praveenreddy0073/Disaster-Resilient-Offline-LoRa-SOS-Communication/LoRa_SOS_Professional_v2.pptx

OFFLINE

ESP32 LoRa Mesh

SOS Emergency
Communication System

Offline ESP32 LoRa Mesh SOS System · Full Firmware + Captive Portal + Rescue Dashboard

SOS

EMERGENCY BEACON

433 MHz · ESP32 · LoRa · FreeRTOS

Department of Electronics & Communication

2026

Captive Portal

Mesh Relay

Rescue Dashboard

~3 km

LoRa Range

< $15

Cost / Node

0 Internet

Required

1 / 11

## Slide 2

Table of Contents

What we will cover today

Offline ESP32 LoRa Mesh SOS System

Project Overview & Motivation

Why offline LoRa beats cellular in emergencies

Node 3 — Mesh Relay

Hop limit, dedup cache, jitter anti-collision

01

06

System Architecture

3-node mesh: Transmitter → Relay → Base Station

Software Stack

Arduino IDE, libraries, FreeRTOS architecture

02

07

Hardware & Wiring

ESP32 + LoRa SX1278 + I²C LCD pin mapping

03

Live Demo Flow

8-step walkthrough: Power Up → SAVED

08

Node 1 — SOS Transmitter

Captive Portal + PWA + RTOS dual-core LoRa task

04

Technical Deep-Dive

Thread safety, reliability, captive portal compat

09

Node 2 — Base Station

LCD alarms + Rescue Dashboard + ACK broadcast

05

Results & Future Work

Achievements, cost summary, enhancements roadmap

10

2 / 11

## Slide 3

01 — Project Overview & Motivation

Disaster scenarios where cellular networks fail but LoRa still works

Offline ESP32 LoRa Mesh SOS System

THE PROBLEM

Earthquakes, floods & tsunamis destroy cell towers first

GPS satellites still function — but data has nowhere to go

Victims cannot call for help or share their location

Rescue teams operate blind without victim coordinates

Satellite communicators (Garmin inReach) cost $400–$600

GSM modules require SIM cards, data plans & signal coverage

OUR SOLUTION

Self-contained mesh using ESP32 + LoRa — no infrastructure

Victim's phone connects to WiFi hotspot (no SIM needed)

Browser auto-opens SOS web app via Captive Portal

GPS coords transmitted over LoRa radio to rescue base

Rescue team views real-time dashboard, resolves & ACKs

Total hardware cost: under $15 per node (~₹1,200)

3 / 11

## Slide 4

02 — System Architecture

End-to-end packet flow: victim phone → LoRa mesh → rescue operator

SOS: "SOS:[ID]:[LAT]:[LON]:[HOPS]" e.g. SOS:1749382:12.9716:77.5946:1
ACK: "ACK:[ID]:[HOPS]" e.g. ACK:1749382:1

Offline ESP32 LoRa Mesh SOS System

NODE 1

SOS TRANSMITTER

WiFi AP: SOS_EMERGENCY_AP

IP: 192.168.4.1

Captive Portal Web App

RTOS LoRa TX (Core 0)

PACKET FORMATS

NODE 3

MESH RELAY

WiFi AP: RELAY_NODE_3

IP: 192.168.6.1

Hop limit: 2

Jitter: 50–180 ms

NODE 2

BASE STATION

WiFi AP: RESCUE_BASE_AP

IP: 192.168.5.1

I²C LCD Display

Rescue Dashboard

LoRa 433 MHz · SF7 · BW 125kHz · CR 4/5

SOS ▶

SOS ▶

◀ ACK

◀ ACK

4 / 11

## Slide 5

03 — Hardware Components & Wiring

SPI pin mapping identical across all three nodes — 3.3 V strict

SPI WIRING — ALL NODES

⚠ CRITICAL: LoRa SX1278 / Ra-02 operates at 3.3 V strictly. Applying 5 V to VCC will permanently destroy the RF front-end.

Offline ESP32 LoRa Mesh SOS System

BILL OF MATERIALS

Function

Power — NEVER connect to 5V!

Ground

SPI Master In Slave Out

SPI Master Out Slave In

SPI Clock

SPI Chip Select

Module Reset

Interrupt (not GPIO 2)

Component

ESP32 WROOM-32

Used on

All nodes

Cost

~$4.00

LoRa Pin

VCC

ESP32 GPIO

3.3 V

LoRa SX1278 (Ra-02)

All nodes

~$4.50

GND

MISO

GND

GPIO 19

16×2 I²C LCD

Jumper wires

Node 2 only

All nodes

~$2.50

~$1.00

MOSI

GPIO 23

USB cable

Programming

~$1.00

SCK

NSS

GPIO 18

GPIO 5

Breadboard

Prototyping

~$1.50

RST

GPIO 14

DIO0

GPIO 4

5 / 11

## Slide 6

04 — Node 1: SOS Transmitter

WiFi Captive Portal + Embedded PWA + RTOS LoRa broadcast

Offline ESP32 LoRa Mesh SOS System

CAPTIVE PORTAL

SSID: SOS_EMERGENCY_AP (open — no password)

DNS wildcard: any domain → 192.168.4.1

Android support: /generate_204 endpoint

Windows support: /fwlink endpoint

HTML/CSS/JS embedded in ESP32 flash (app_html.h)

RTOS DUAL-CORE ARCHITECTURE

SOS WEB APP (PWA)

Auto-reads GPS via browser Geolocation API

Manual coordinate entry if GPS is denied

Glowing SOS button — tap to broadcast

Polls /status every 2 s: IDLE → BROADCASTING → SAVED

Installable as offline PWA (manifest.json + sw.js)

CORE 0 — loraTask()

• Retransmits SOS every 4 s (or on new packet ID)
• Listens for incoming ACK packets
• Auto-timeout: 60 s with no ACK → resets to IDLE

mutex

CORE 1 — Web Server + DNS Loop

• Handles HTTP: /send_sos, /status, /reset_status
• dnsServer.processNextRequest() — captive portal
• RTOS mutex (loraMutex) guards all SPI access

6 / 11

## Slide 7

05 — Node 2: Base Station Receiver

LCD alarm + Rescue Dashboard + non-blocking ACK broadcast on Core 0

ACK BROADCAST SEQUENCE (Core 0 — non-blocking)

Offline ESP32 LoRa Mesh SOS System

LORA RECEPTION & LCD

Parses SOS:[ID]:[LAT]:[LON]:[HOPS] — strips hop field

Stores up to 10 alerts in memory (struct SOSAlert[])

De-duplicates by packet ID — silent re-RSSI update

LCD row 0: "SOS! RSSI:−72dB" | Row 1: coordinates

Backlight flashes at 200 ms for 1 s to attract attention

RESCUE DASHBOARD (http://rescue.local)

WiFi AP: RESCUE_BASE_AP | IP: 192.168.5.1

mDNS: http://rescue.local (ESPmDNS library)

Live alert list: ID, RSSI, coords, Google Maps link

"Resolve" → spawns RTOS ackSendTask on Core 0

LCD shows "RESCUED! ACK Sent" with coordinates

Operator
clicks Resolve

1

alert.active
= false

2

malloc(AckJob)
struct on heap

3

xTaskCreatePinnedToCore
Core 0 ackSendTask

4

Send ACK 3×
400 ms gaps

5

free(job)
vTaskDelete

6

7 / 11

## Slide 8

06 — Node 3: Mesh Relay / Repeater

Hop-limited, dedup-cached, jitter-delayed intelligent relay node

If Node 1 (just transmitted) and Node 3 (about to relay) both transmit simultaneously, the signals collide on 433 MHz and corrupt each other — neither packet is received correctly.
Random jitter staggers TX windows. Same principle as CSMA/CA in WiFi and Bluetooth FHSS.

Offline ESP32 LoRa Mesh SOS System

RELAY LOGIC

Listens on 433 MHz for SOS and ACK packets

Hop-limit check: discard if HOPS ≥ 2 (configurable)

Seen-cache ring buffer (30 entries) blocks duplicates

Increments hop count, rebuilds packet before relay

Schedules relay after random jitter (50–180 ms)

GPIO 2 LED blinks 30 ms on each forwarded packet

WHY RANDOM JITTER?

RELAY STATUS DASHBOARD (192.168.6.1)

WiFi AP: RELAY_NODE_3 (no DNS, direct IP access)

Shows last 12 relayed events with RSSI + timestamp

Live counters: SOS forwarded / ACK forwarded / Drops

JSON API: GET /status_json (poll from any client)

Malformed packet detection with serial debug output

8 / 11

## Slide 9

07 — Software Stack & Libraries

Arduino IDE + ESP32 board package + FreeRTOS — all open-source, free

Key APIs Used in this Project

SPI LoRa driver — beginPacket / endPacket / parsePacket / packetRssi

I²C 16×2 LCD — init, backlight, noBacklight, print, setCursor

WIFI_AP_STA mode — softAP, softAPConfig, begin, SSID, localIP

HTTP server — on(), send(), sendHeader(), send_P(), method()

DNS wildcard — start(port, "*", ip) for captive portal redirect

Multicast DNS — MDNS.begin("rescue") → http://rescue.local

xTaskCreatePinnedToCore, xSemaphoreCreateMutex, vTaskDelay, malloc

File › Preferences › add ESP32 board URL → Board Manager › "esp32 by Espressif" → Library Manager › LoRa + LiquidCrystal_I2C → Upload .ino to each node

Offline ESP32 LoRa Mesh SOS System

Library

LoRa

Author

Sandeep Mistry

LiquidCrystal_I2C

F. de Brabander

WiFi.h

ESP32 built-in

WebServer.h

ESP32 built-in

DNSServer.h

ESP32 built-in

ESPmDNS.h

ESP32 built-in

FreeRTOS

ESP-IDF / built-in

SETUP:

9 / 11

## Slide 10

08 — Live Demo: Step-by-Step Operation

Trace a complete SOS event from trigger to resolution

Offline ESP32 LoRa Mesh SOS System

Power Up All Nodes

Connect all 3 ESP32s to USB power. Open Serial Monitor @ 115200 baud. Node 2 LCD shows "LoRa Ready / Waiting for data".

Connect to WiFi

On victim phone: Settings → WiFi → connect to "SOS_EMERGENCY_AP". No password required.

Captive Portal Opens

Phone auto-launches "SOS Emergency Beacon" in browser. GPS is silently read in background.

Trigger SOS

Tap the red SOS button. Status changes to BROADCASTING. ESP32 transmits LoRa every 4 seconds.

01

02

03

04

Node 3 Relays

Relay receives packet, checks seen-cache, increments hop count, waits jitter delay, re-broadcasts.

Node 2 Receives

LCD backlight flashes rapidly. Screen shows coordinates + RSSI. Dashboard auto-updates.

Operator Resolves

Operator connects to RESCUE_BASE_AP → opens http://rescue.local → clicks Resolve.

Victim Saved

ACK broadcast 3×. Node 3 relays ACK back. Node 1 receives → phone portal shows "SAVED ✅".

05

06

07

08

10 / 11

## Slide 11

09 — Technical Deep-Dive

Thread safety, reliability patterns, captive portal compatibility

Offline ESP32 LoRa Mesh SOS System

THREAD SAFETY

loraMutex (xSemaphoreCreateMutex) guards every LoRa SPI call

Core 0 task and Core 1 web handler never touch SPI simultaneously

AckJob allocated on heap — no shared String across cores

Volatile keyword on systemStatus for cross-core visibility

CAPTIVE PORTAL COMPAT.

/generate_204 → Android CNA (Captive Network Assist)

/fwlink → Windows Network Assessment Service

DNS wildcard (*) → all domains resolve to 192.168.4.1

Cache-Control: no-cache headers prevent stale portal page

RELIABILITY FEATURES

SOS retransmit every 4 s until ACK or 60 s hard timeout

ACK sent 3× with 400 ms spacing — survives single-packet loss

LoRa init failure handled gracefully (WiFi-only fallback)

RESOLVE:[ID] serial command bypasses WiFi if dashboard fails

DUPLICATE PREVENTION

Node 1: lastSentPacketID tracks in-flight packet ID

Node 2: addAlert() by ID — reactivates, never double-counts

Node 3: seenCache[30] ring buffer — O(n) scan before relay

Malformed packets detected and counted as drops silently

11 / 11

## Slide 12

10 — Results & Future Work

Achievements, cost analysis, and the roadmap ahead

Offline ESP32 LoRa Mesh SOS System

WHAT WE ACHIEVED

Complete offline SOS system — zero internet dependency

Captive portal with live GPS on any modern smartphone

Real-time Rescue Dashboard with Google Maps coordinates

Intelligent mesh relay — hop limit + collision avoidance

Thread-safe dual-core RTOS firmware architecture

Graceful degradation if LoRa hardware fails to init

FUTURE ENHANCEMENTS

Extend mesh with 5+ relay nodes (multi-hop routing)

AES-128 packet encryption to prevent SOS spoofing

Solar + LiPo power for 72-hour autonomous deployment

LoRaWAN uplink when internet is restored post-disaster

Multi-language portal (Hindi, Tamil, local languages)

Low-power deep sleep between transmit cycles

$4.00

ESP32 WROOM-32

$4.50

LoRa SX1278

$2.50

I²C LCD (Node 2)

$2.50

Wires & misc.

≈$13.50

Total / Node

12 / 11

## Slide 13

THANK YOU

Questions & Discussion

Offline ESP32 LoRa Mesh SOS System

Department of Electronics & Communication · 2026 · github.com/[your-handle]/lora-sos-mesh

KEY SPECIFICATIONS

433 MHz

LoRa Frequency

< $15

Cost per Node

~3 km

Open-air Range

0

Internet Required

PROJECT SUMMARY

Node 1 → SOS_EMERGENCY_AP / 192.168.4.1

Node 2 → RESCUE_BASE_AP / http://rescue.local

Node 3 → RELAY_NODE_3 / 192.168.6.1

LoRa: 433 MHz | Baud: 115200 | Cost: < $15 / node

2 Hops

Max Mesh Depth

3

Total Nodes

13 / 11
