praveenreddy0073/Disaster-Resilient-Offline-LoRa-SOS-Communication/base_station_website.jpeg

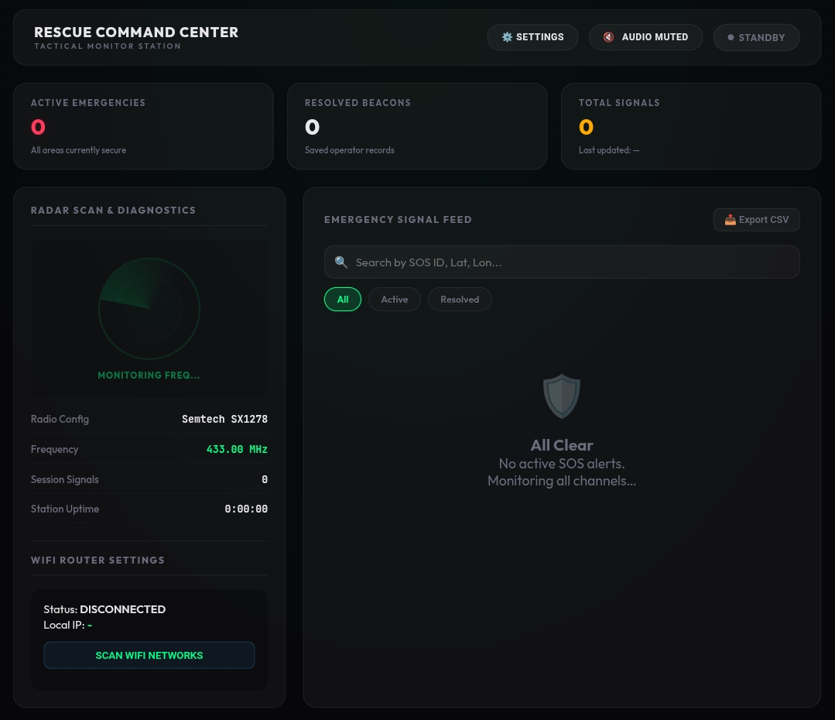
base_station_website.jpeg
