praveenreddy0073/Disaster-Resilient-Offline-LoRa-SOS-Communication/captive_portal.jpeg

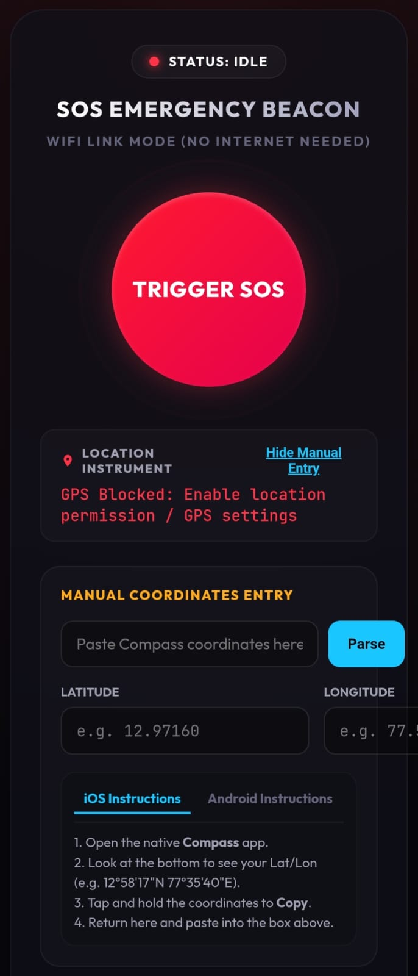
captive_portal.jpeg
