praveenreddy0073/Disaster-Resilient-Offline-LoRa-SOS-Communication/pcb editor.kicad_pcb

## KiCad design pcb editor.kicad_pcb (2026-07-18)

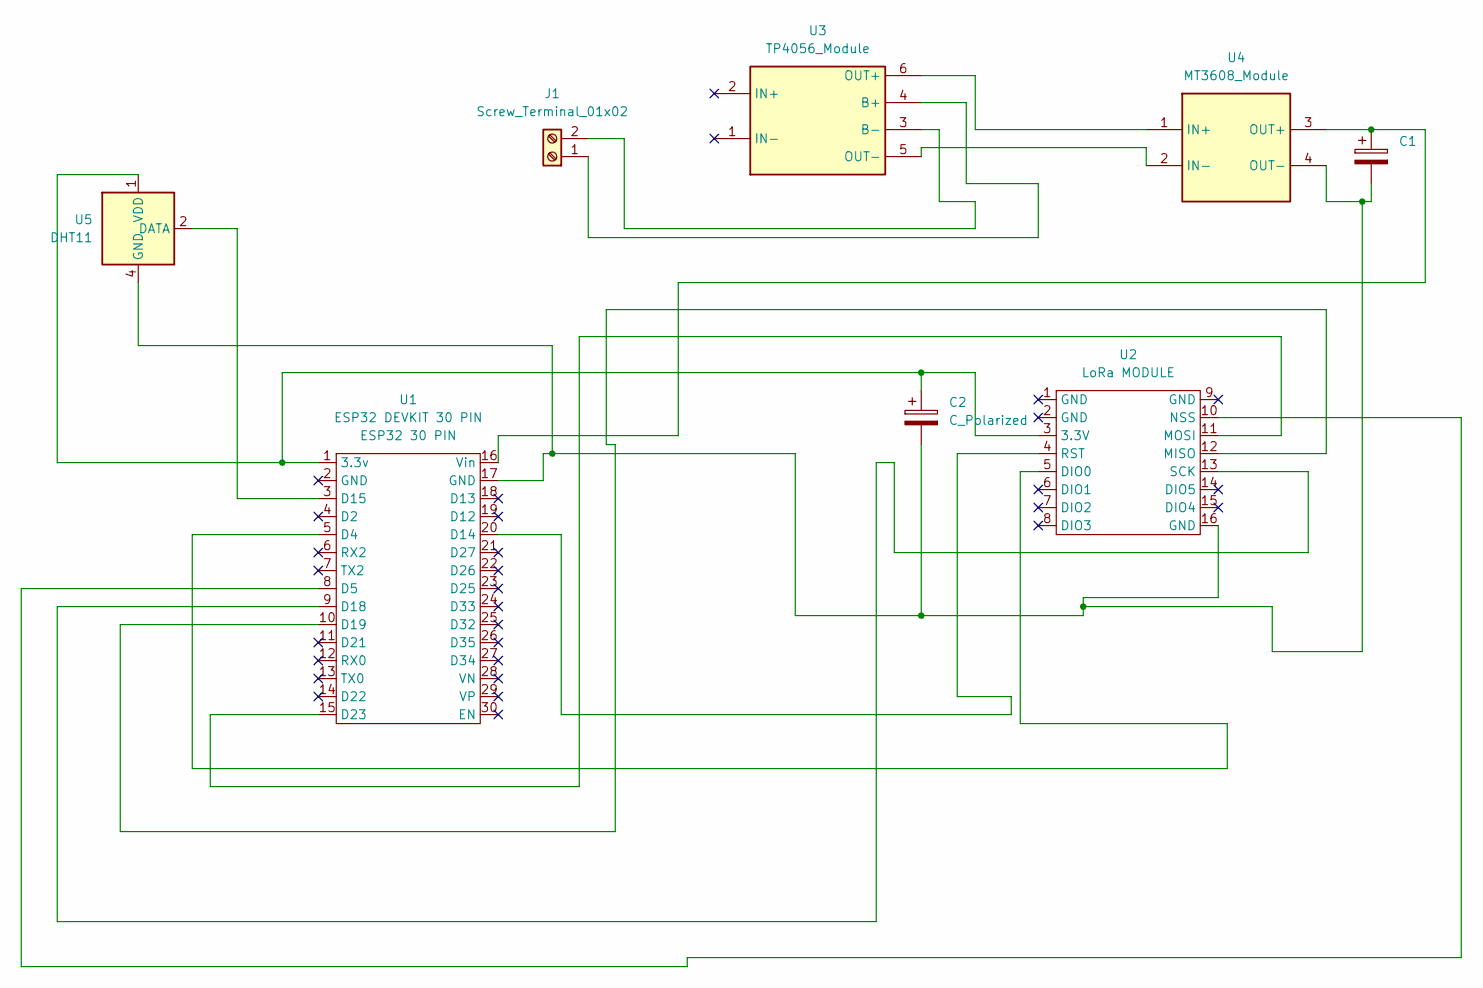
[picture p16: schematic schemetic.kicad_sch]

Parts:
C1: CP_Radial_D10.0mm_P5.00mm
C2: C_Polarized; CP_Radial_D10.0mm_P5.00mm
J1: Screw_Terminal_01x02; TerminalBlock_MaiXu_MX126-5.0-02P_1x02_P5.00mm
U1: ESP32 DEVKIT 30 PIN; ESP32 30 PIN
U2: LoRa MODULE; LORA MODULE
U3: TP4056_Module
U4: MT3608_Module
U5: DHT11; Aosong_DHT11_5.5x12.0_P2.54mm

Connections:
unnamed: J1.1, U3.4 (B+)
unnamed: J1.2, U3.3 (B-)
unnamed: C2.1, U1.1 (3.3v), U2.3 (3.3V), U5.1 (VDD)
unnamed: U1.5 (D4), U2.5 (DIO0)
unnamed: U1.8 (D5), U2.10 (NSS)
unnamed: U1.20 (D14), U2.4 (RST)
unnamed: U1.3 (D15), U5.2 (DATA)
unnamed: U1.9 (D18), U2.13 (SCK)
unnamed: U1.10 (D19), U2.12 (MISO)
unnamed: U1.15 (D23), U2.11 (MOSI)
unnamed: C1.1, U1.16 (Vin), U4.3 (OUT+)
unnamed: U3.6 (OUT+), U4.1 (IN+)
unnamed: U3.5 (OUT-), U4.2 (IN-)
unnamed: C1.2, C2.2, U1.17 (GND), U2.16 (GND), U4.4 (OUT-), U5.4 (GND)

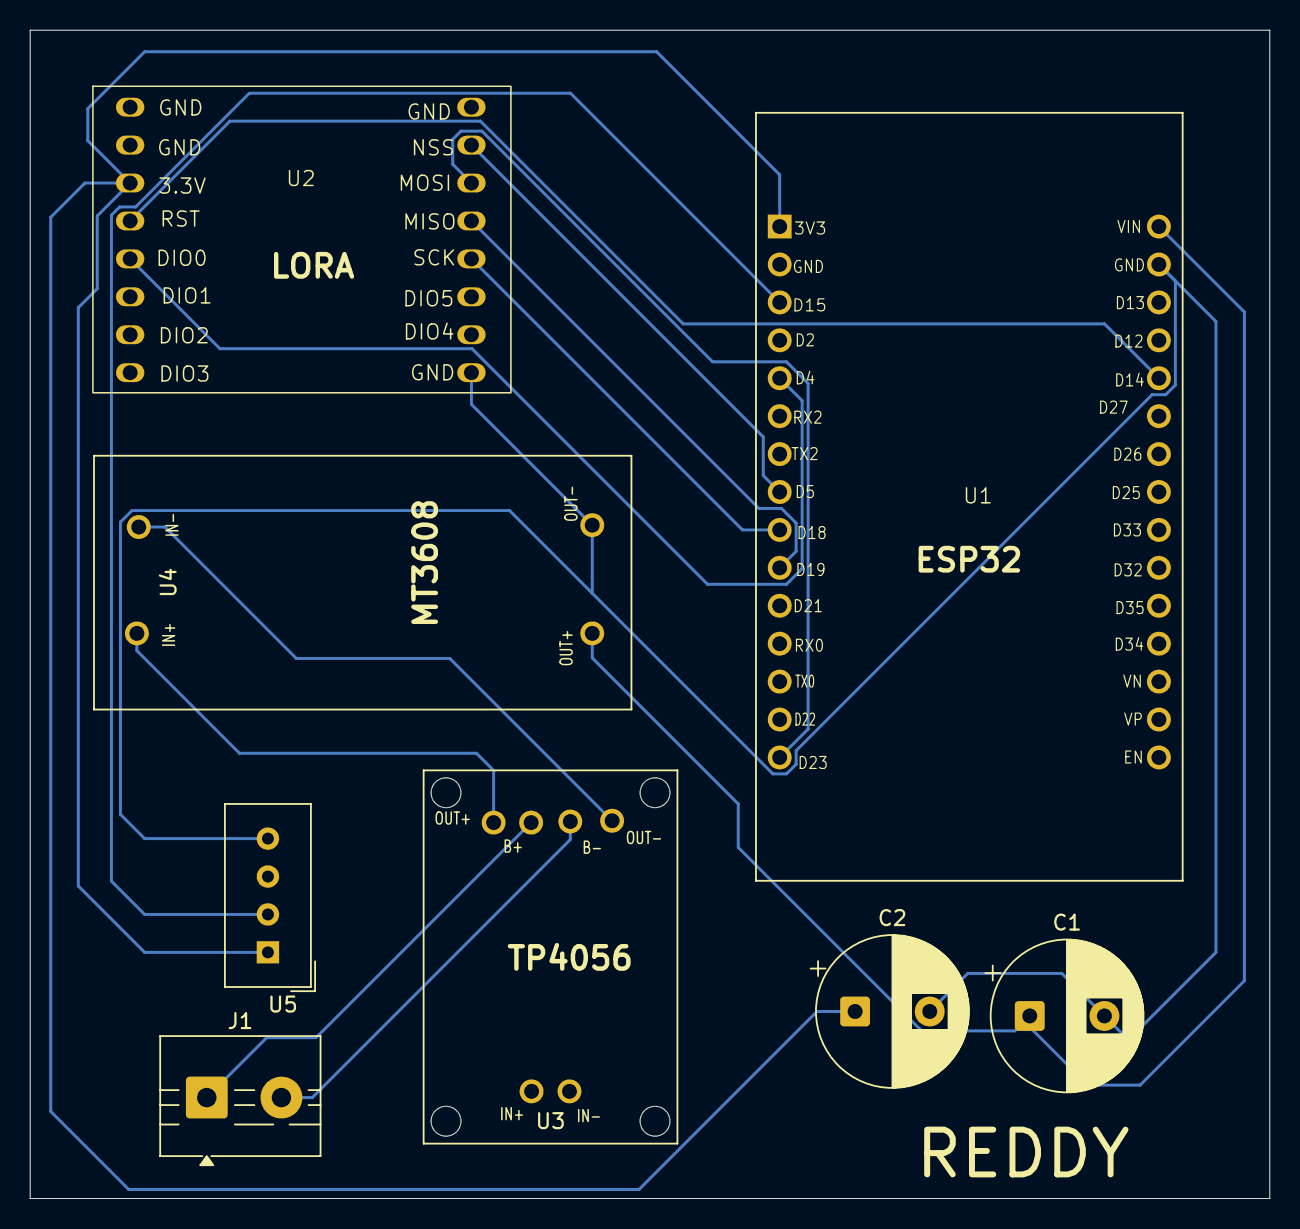
[picture p17: board pcb editor.kicad_pcb from above]

Board: 2 copper layers, 83.0 x 78.2 mm, 8 parts (0 on the bottom side), 14 nets.
